HandHeldLegend/RetroGlowPlus-GBC/Alt-HW/retroglowplus_gbc.kicad_pcb

## KiCad design Alt-HW/retroglowplus_gbc.kicad_pcb (2024-07-04)

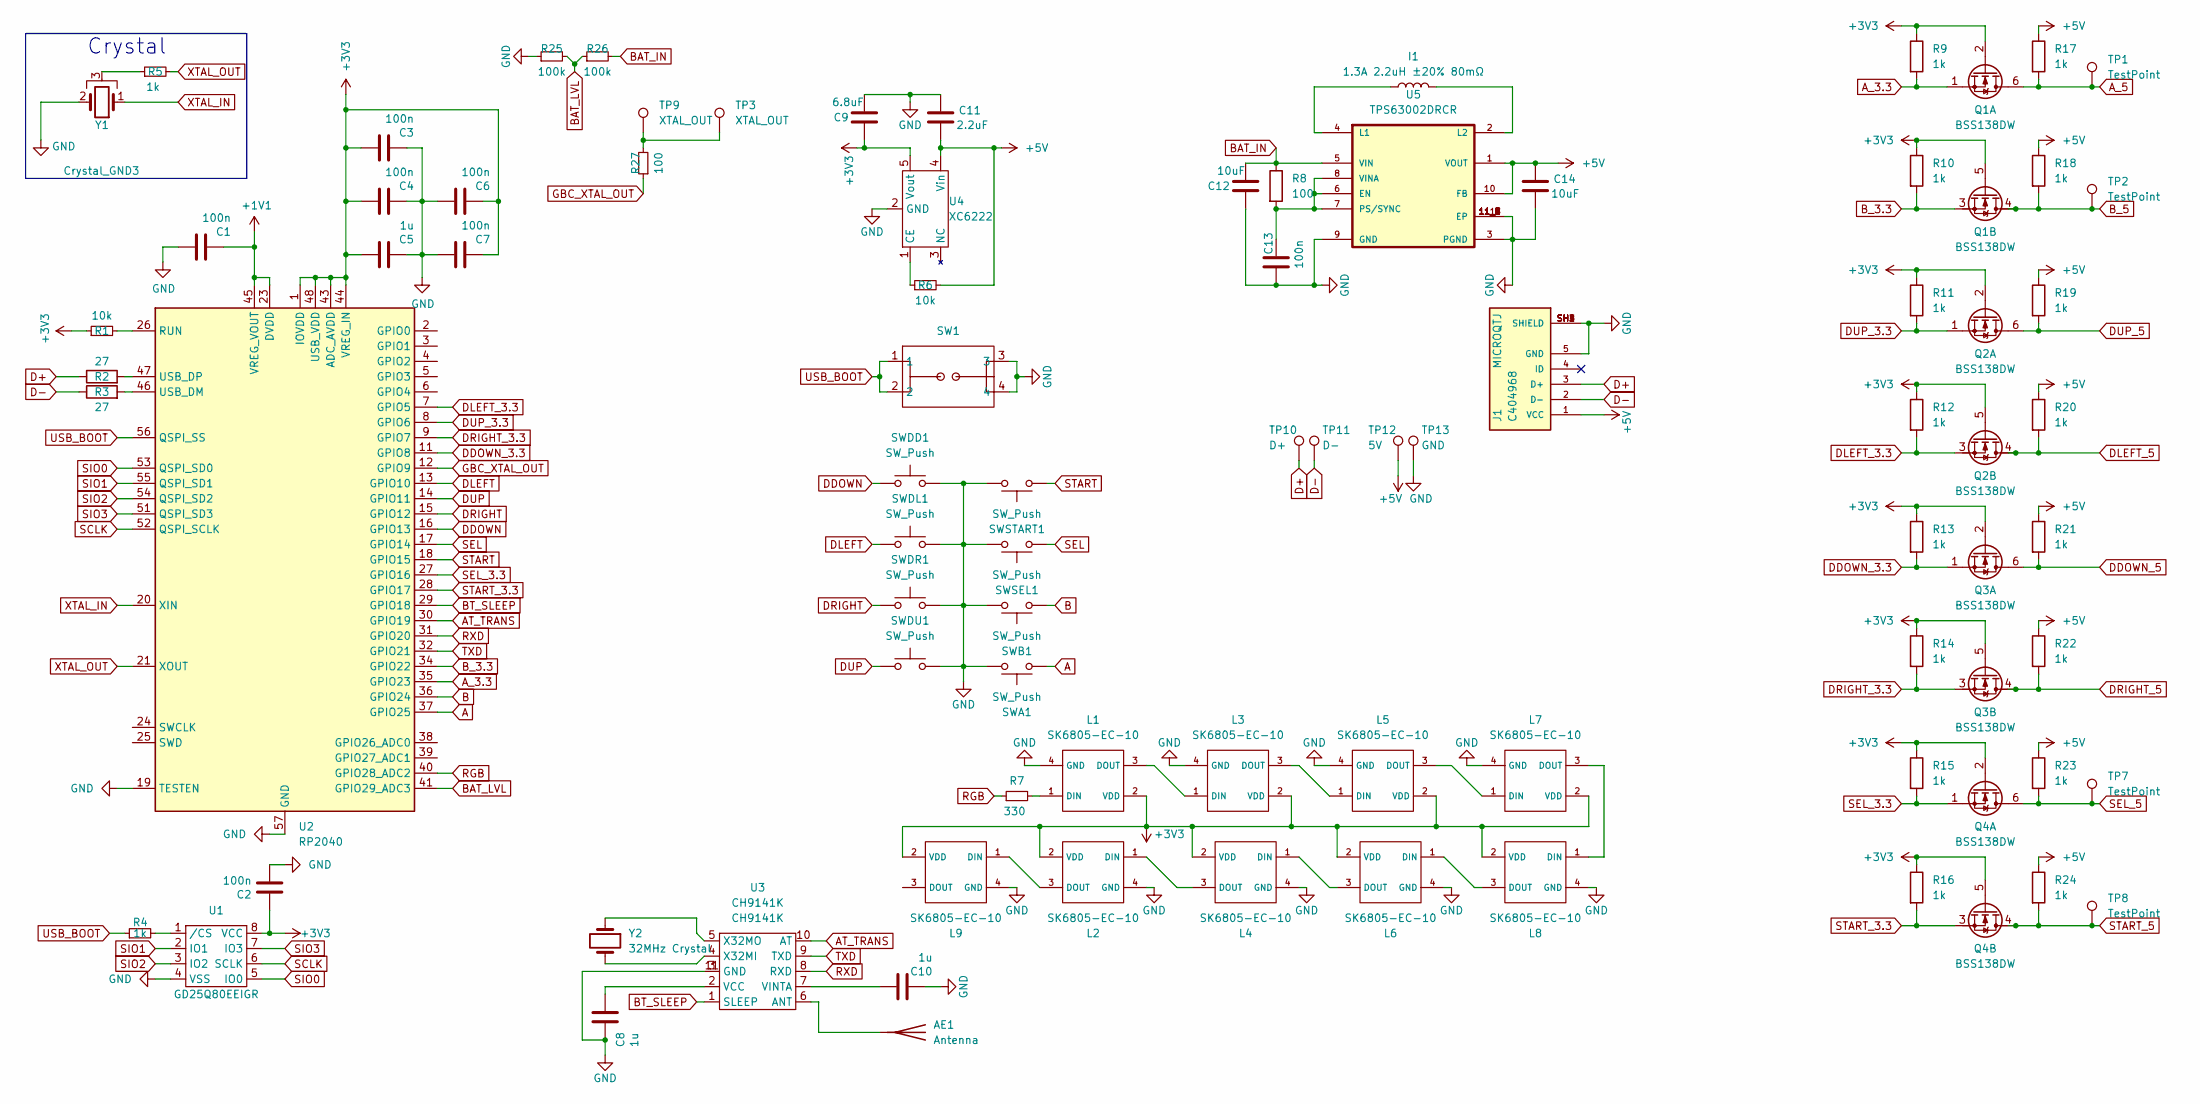
[picture p1: schematic retroglowplus_gbc.kicad_sch]

Parts:
AE1: Antenna; L_1206_3216Metric; MPN 2450AT18A100E
C1, C3, C4, C6, C7: 100n; C_0402_1005Metric
C2, C13: 100n; C_0201_0603Metric
C5, C8, C10: 1u; C_0402_1005Metric
C9: 6.8uF; C_0603_1608Metric
C11: 2.2uF; C_0603_1608Metric
C12, C14: 10uF; C_0805_2012Metric
I1: 1.3A 2.2uH ±20% 80mΩ; L_1008_2520Metric; MPN MIP25202R2MBE; LCSC C315721
J1: MICROQTJ; SHOUHAN_MICROQTJ; PARTREV A/0; LCSC C404968
L1, L2, L3, L4, L5, L6, L7, L8, L9: SK6805-EC-10
Q1, Q2, Q3, Q4: BSS138DW; SOT-363_SC-70-6; MPN BSS138DW-7-F; LCSC C154900
R1, R6: 10k; R_0201_0603Metric
R2, R3: 27; R_0201_0603Metric
R4, R5, R9, R10, R11, R12, R13, R14, R15, R16, R17, R18, R19, R20, R21, R22, R23, R24: 1k; R_0201_0603Metric
R7: 330; R_0201_0603Metric
R8, R27: 100; R_0201_0603Metric
R25, R26: 100k; R_0201_0603Metric
SW1: 1TS026A-1000-0550; MPN 1TS026A-1000-0550; LCSC C913778
SWA1: SW_Push; ring_pad_small
SWB1: SW_Push; ring_pad_small
SWDD1: SW_Push; ring_dpad
SWDL1: SW_Push; ring_dpad
SWDR1: SW_Push; ring_dpad
SWDU1: SW_Push; ring_dpad
SWSEL1: SW_Push; GBC_Start_Select
SWSTART1: SW_Push; GBC_Start_Select
TP1, TP2, TP7, TP8: TestPoint; TestPoint_Pad_2.5x2.5mm
TP3, TP9: XTAL_OUT; TestPoint_Pad_2.5x2.5mm
TP10: D+; TestPoint_Pad_2.5x2.5mm
TP11: D-; TestPoint_Pad_2.5x2.5mm
TP12: 5V; TestPoint_Pad_2.5x2.5mm
TP13: GND; TestPoint_Pad_2.5x2.5mm
U1: GD25Q80EEIGR; USON-8-EP(2x3); MPN GD25Q80EEIGR; LCSC C2874937
U2: RP2040; QFN-56-1EP_7x7mm_P0.4mm_EP3.2x3.2mm
U3: CH9141K; ESSOP-10; MPN CH9141K
U4: XC6222; SOT-89-5; MPN XC6222B331PR-G
U5: TPS63002DRCR; VREG_V62_16624-01YE; MPN TPS63002DRCR
Y1: Crystal_GND3; Resonator_SMD_Murata_CSTxExxV-3Pin_3.0x1.1mm; MPN CSTNE12M0GH5L000R0
Y2: 32MHz Crystal; Oscillator_SMD_EuroQuartz_XO32-4Pin_3.2x2.5mm; MPN CF4032M00012T5074007

Connections:
+1V1: C1.2, U2.23 (DVDD), U2.45 (VREG_VOUT), U2.50 (DVDD)
+3V3: C2.1, C3.1, C4.1, C5.1, C6.2, C7.2, C9.1, L1.2 (VDD), L2.2 (VDD), L3.2 (VDD), L4.2 (VDD), L5.2 (VDD), L6.2 (VDD), L7.2 (VDD), L8.2 (VDD), L9.2 (VDD), Q1.2 (G1), Q1.5 (G2), Q2.2 (G1), Q2.5 (G2), Q3.2 (G1), Q3.5 (G2), Q4.2 (G1), Q4.5 (G2), R1.1, R9.1, R10.1, R11.1, R12.1, R13.1, R14.1, R15.1, R16.1, U1.8 (VCC), U2.1 (IOVDD), U2.10 (IOVDD), U2.22 (IOVDD), U2.33 (IOVDD), U2.42 (IOVDD), U2.43 (ADC_AVDD), U2.44 (VREG_IN), U2.48 (USB_VDD), U2.49 (IOVDD), U4.5 (Vout)
+5V: C11.2, C14.1, J1.1 (VCC), R6.2, R17.1, R18.1, R19.1, R20.1, R21.1, R22.1, R23.1, R24.1, TP12.1, U4.4 (Vin), U5.1 (VOUT), U5.10 (FB); also elsewhere on the board
A: SWA1.1, U2.37 (GPIO25)
AT_TRANS: U2.30 (GPIO19), U3.10 (AT)
A_3.3: Q1.1 (S1), R9.2, U2.35 (GPIO23)
A_5: Q1.6 (D1), R17.2, TP1.1
B: SWB1.1, U2.36 (GPIO24)
BAT_IN: C12.2, R8.1, R26.2, U5.5 (VIN); also elsewhere on the board
BAT_LVL: R25.2, R26.1, U2.41 (GPIO29_ADC3)
BT_SLEEP: U2.29 (GPIO18), U3.1 (SLEEP)
B_3.3: Q1.3 (D2), R10.2, U2.34 (GPIO22)
B_5: Q1.4 (S2), R18.2, TP2.1
D+: J1.3 (D+), R2.1, TP10.1
D-: J1.2 (D-), R3.1, TP11.1
DDOWN: SWDD1.1, U2.16 (GPIO13)
DDOWN_3.3: Q3.1 (S1), R13.2, U2.11 (GPIO8)
DDOWN_5: Q3.6 (D1), R21.2
DLEFT: SWDL1.1, U2.13 (GPIO10)
DLEFT_3.3: Q2.3 (D2), R12.2, U2.7 (GPIO5)
DLEFT_5: Q2.4 (S2), R20.2
DRIGHT: SWDR1.1, U2.15 (GPIO12)
DRIGHT_3.3: Q3.3 (D2), R14.2, U2.9 (GPIO7)
DRIGHT_5: Q3.4 (S2), R22.2
DUP: SWDU1.1, U2.14 (GPIO11)
DUP_3.3: Q2.1 (S1), R11.2, U2.8 (GPIO6)
DUP_5: Q2.6 (D1), R19.2
GBC_XTAL_OUT: R27.1, U2.12 (GPIO9)
GND: C1.1, C2.2, C3.2, C4.2, C5.2, C6.1, C7.1, C8.2, C9.2, C10.2, C11.1, C12.1, C13.1, C14.2, J1.5 (GND), J1.SH1 (SHIELD), J1.SH2 (SHIELD), J1.SH3 (SHIELD), J1.SH4 (SHIELD), L1.4 (GND), L2.4 (GND), L3.4 (GND), L4.4 (GND), L5.4 (GND), L6.4 (GND), L7.4 (GND), L8.4 (GND), L9.4 (GND), R25.1, SW1.3, SW1.4, SWA1.2, SWB1.2, SWDD1.2, SWDL1.2, SWDR1.2, SWDU1.2, SWSEL1.2, SWSTART1.2, TP13.1, U1.4 (VSS), U2.19 (TESTEN), U2.57 (GND), U3.3 (GND), U3.11 (GND), U4.2 (GND), U5.3 (PGND), U5.9 (GND), U5.11 (EP), U5.11_1 (EP), U5.11_2 (EP), U5.11_3 (EP), U5.11_4 (EP), U5.11_5 (EP), U5.11_6 (EP), U5.11_7 (EP), U5.11_8 (EP), Y1.2; also elsewhere on the board
unnamed: AE1.1 (A), U3.6 (ANT)
unnamed: L1.1 (DIN), R7.2
unnamed: L1.3 (DOUT), L3.1 (DIN)
unnamed: L2.1 (DIN), L4.3 (DOUT)
unnamed: L2.3 (DOUT), L9.1 (DIN)
unnamed: L3.3 (DOUT), L5.1 (DIN)
unnamed: L4.1 (DIN), L6.3 (DOUT)
unnamed: L5.3 (DOUT), L7.1 (DIN)
unnamed: L6.1 (DIN), L8.3 (DOUT)
unnamed: L7.3 (DOUT), L8.1 (DIN)
unnamed: R5.1, Y1.3
unnamed: R27.2, TP3.1, TP9.1
unnamed: R4.2, U1.1 (/CS)
unnamed: R1.2, U2.26 (RUN)
unnamed: R3.2, U2.46 (USB_DM)
unnamed: R2.2, U2.47 (USB_DP)
unnamed: C8.1, U3.2 (VCC)
unnamed: C10.1, U3.7 (VINTA)
unnamed: U3.4 (X32MI), Y2.2
unnamed: U3.5 (X32MO), Y2.1
unnamed: R6.1, U4.1 (CE)
unnamed: C13.2, R8.2, U5.6 (EN), U5.7 (PS/SYNC), U5.8 (VINA)
unnamed: I1.1, U5.4 (L1)
unnamed: I1.2, U5.2 (L2)
RGB: R7.1, U2.40 (GPIO28_ADC2)
RXD: U2.31 (GPIO20), U3.8 (RXD)
SCLK: U1.6 (SCLK), U2.52 (QSPI_SCLK)
SEL: SWSEL1.1, U2.17 (GPIO14)
SEL_3.3: Q4.1 (S1), R15.2, U2.27 (GPIO16)
SEL_5: Q4.6 (D1), R23.2, TP7.1
SIO0: U1.5 (IO0), U2.53 (QSPI_SD0)
SIO1: U1.2 (IO1), U2.55 (QSPI_SD1)
SIO2: U1.3 (IO2), U2.54 (QSPI_SD2)
SIO3: U1.7 (IO3), U2.51 (QSPI_SD3)
START: SWSTART1.1, U2.18 (GPIO15)
START_3.3: Q4.3 (D2), R16.2, U2.28 (GPIO17)
START_5: Q4.4 (S2), R24.2, TP8.1
TXD: U2.32 (GPIO21), U3.9 (TXD)
USB_BOOT: R4.1, SW1.1, SW1.2, U2.56 (QSPI_SS)
XTAL_IN: U2.20 (XIN), Y1.1
XTAL_OUT: R5.2, U2.21 (XOUT)

Notes on the sheet:
Crystal

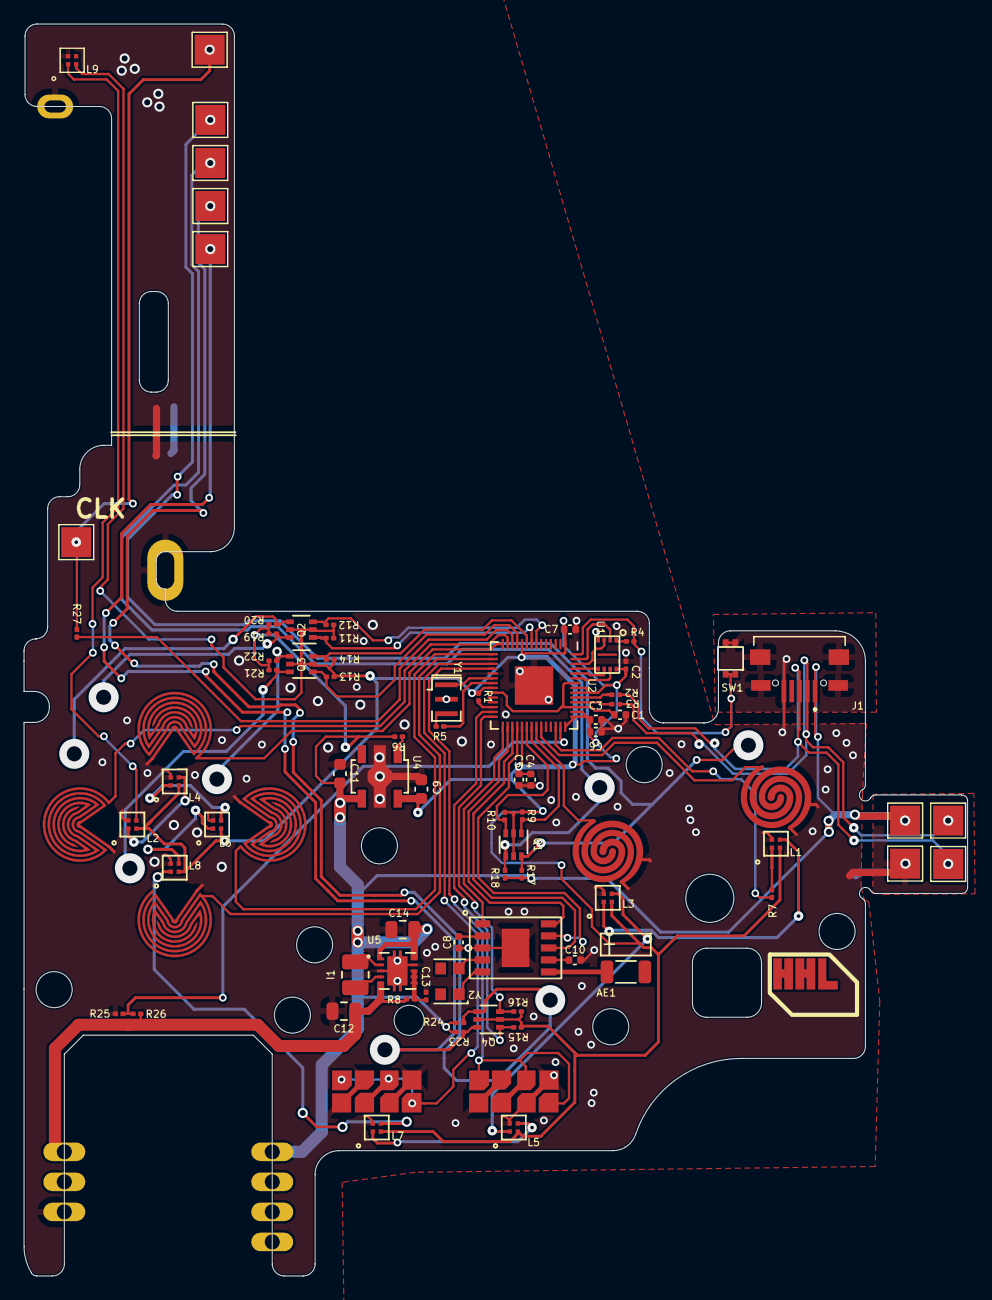
[picture p2: board retroglowplus_gbc.kicad_pcb from above]

Board: 2 copper layers, 78.5 x 104.2 mm, 93 parts (0 on the bottom side), 70 nets.

Other parts of the board:
BAT1: TestPoint_Plated_Hole_D2.0mm
G1, G2, G3: TestPoint_Plated_Hole_D2.0mm
LOGO: HHL_Logo
NC1, NC2, NC3, NC4: TestPoint_Plated_Hole_D2.0mm
VOUT1: TestPoint_Plated_Hole_D2.0mm

Their connections:
+5V: VOUT1.1; also elsewhere on the board
BAT_IN: BAT1.1; also elsewhere on the board
GND: G1.1, G2.1, G3.1; also elsewhere on the board
