HandHeldLegend/RetroGlowPlus-GBC/FW/include/main.h

#include "hoja_includes.h"

#define GPIO_DLEFT_3    5
#define GPIO_DUP_3      6
#define GPIO_DRIGHT_3   7
#define GPIO_DDOWN_3    8
#define GPIO_DLEFT      10
#define GPIO_DUP        11
#define GPIO_DRIGHT     12
#define GPIO_DDOWN      13
#define GPIO_SELECT     14
#define GPIO_START      15
#define GPIO_SELECT_3   16
#define GPIO_START_3    17
#define GPIO_BT_SLEEP   18
#define GPIO_AT_TRANS   19
#define GPIO_RXD        20
#define GPIO_TXD        21
#define GPIO_B_3        22
#define GPIO_A_3        23
#define GPIO_B          24
#define GPIO_A          25
#define GPIO_BAT_LEVEL  29
#define ADC_BAT_LEVEL   3

  
