HandHeldLegend/RetroGlowPlus-GBC/(commit log)

2024-04-02 Add 2 layer
    [retroglowplus_gbc.csv, retroglowplus_gbc.kicad_pcb, retroglowplus_gbc.kicad_sch]
2024-04-03 Add gerbers
    [retroglowplus_gbc-B_Cu.gbr, retroglowplus_gbc-B_Mask.gbr, retroglowplus_gbc-B_Paste.gbr, retroglowplus_gbc-B_Silkscreen.gbr, retroglowplus_gbc-Edge_Cuts.gbr, retroglowplus_gbc-F_Cu.gbr, retroglowplus_gbc-F_Mask.gbr, retroglowplus_gbc-F_Paste.gbr]
